nikolozka/teacher.solar/Documentation/annot.jpg

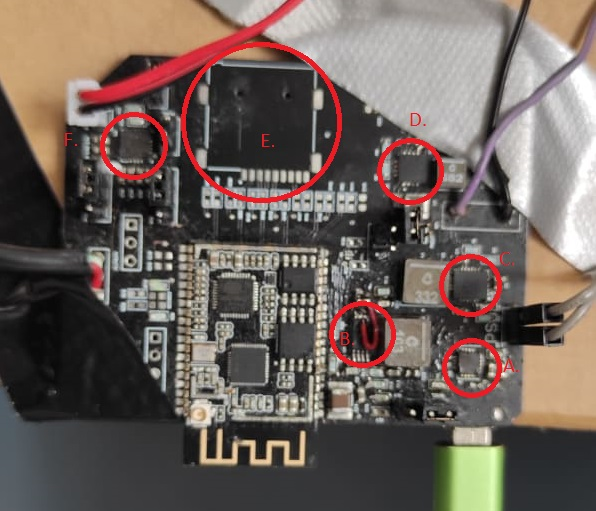
Documentation/annot.jpg
