nikolozka/teacher.solar/Documentation/242728832_872230910085273_4497362481227015161_n.jpg

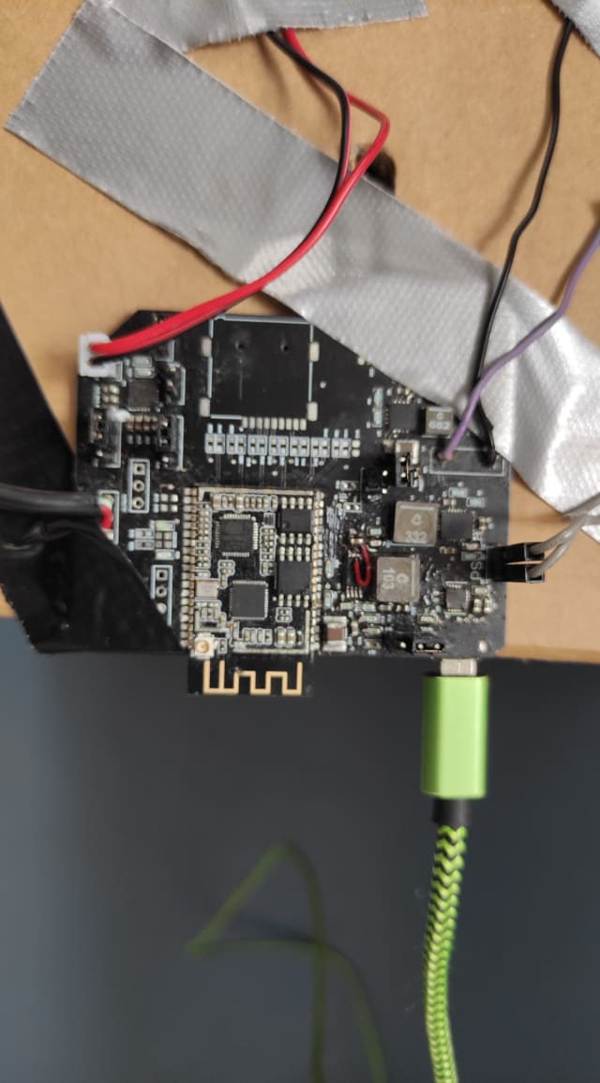
Documentation/242728832_872230910085273_4497362481227015161_n.jpg
