nikolozka/teacher.solar/Teacher.Solar/194192946_691922324912333_2375919402082609091_n.jpg

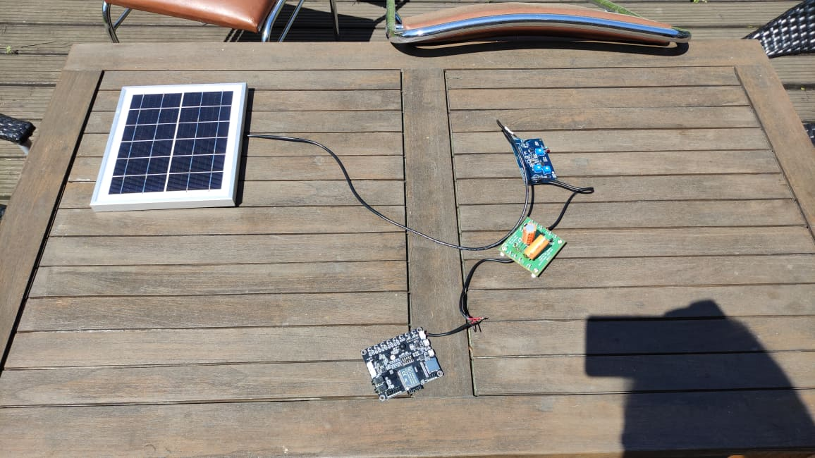
Teacher.Solar/194192946_691922324912333_2375919402082609091_n.jpg
