nikolozka/teacher.solar/(list of files, drawings)

Other design files:
PCB Projects/Solears_v1/Consumer.SchDoc
PCB Projects/Solears_v1/Harvester.SchDoc
PCB Projects/Solears_v1/Solears_v1.PcbDoc
PCB Projects/Solears_v1/Solears_v1.PrjPcb
PCB Projects/Solears_v3/Consumer.SchDoc
PCB Projects/Solears_v3/Harvester.SchDoc
PCB Projects/Solears_v3/PCB_Project/PCB_Project.PrjPcb
PCB Projects/Solears_v3/PCB_Project/Solears_V3.PrjPcb
PCB Projects/Solears_v3/Solears_v3.PcbDoc
