nikolozka/teacher.solar/Teacher.Solar/minisc.brd

## EAGLE design Teacher.Solar/minisc.brd (2023-11-09)

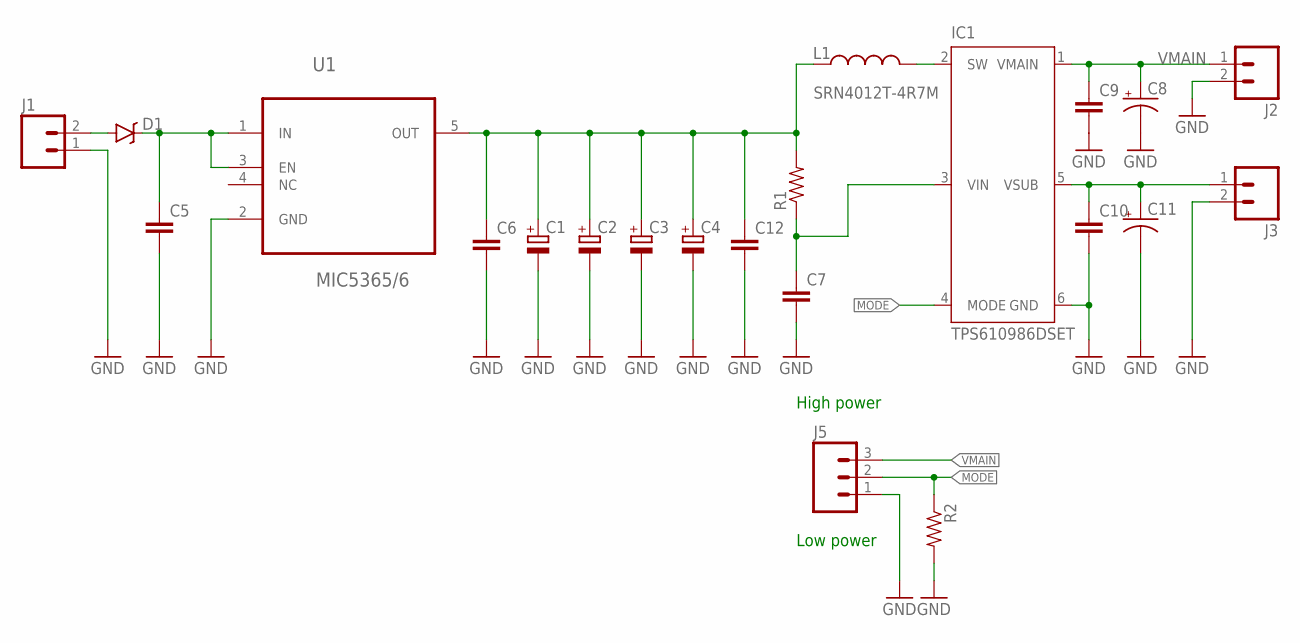
[picture p7: schematic minisc.sch]

Parts:
C1, C2, C3, C4: CPOL-EUE3.5-8; E3,5-8
C5, C6, C7, C9, C10, C12: CAP0805; 0805
C8, C11: CAP_POL3528-KIT; EIA3528-KIT
D1: DIODE-SCHOTTKY-BAT20J; SOD-323
IC1: TPS610986DSET; WSON-6
J1, J2, J3: M02PTH; 1X02
J5: M03PTH; 1X03
L1: SRN4012T-4R7M; CR54
R1, R2: RESISTOR0805-RES; 0805
U1: MIC5365/6; SC-70-5

Connections:
GND: C1.-, C2.-, C3.-, C4.-, C5.2, C6.2, C7.2, C8.C (-), C9.2, C10.2, C11.C (-), C12.2, IC1.6 (GND), J1.1, J2.2, J3.2, J5.1, R2.2, U1.2 (GND)
MODE: IC1.4 (MODE), J5.2, R2.1
unnamed: C5.1, D1.C, U1.1 (IN), U1.3 (EN)
unnamed: C1.+, C2.+, C3.+, C4.+, C6.1, C12.1, L1.P$1 (1), R1.2, U1.5 (OUT)
unnamed: IC1.2 (SW), L1.P$2 (2)
unnamed: C7.1, IC1.3 (VIN), R1.1
unnamed: C10.1, C11.A (+), IC1.5 (VSUB), J3.1
unnamed: D1.A, J1.2
VMAIN: C8.A (+), C9.1, IC1.1 (VMAIN), J2.1, J5.3

Notes on the sheet:
High power
Low power

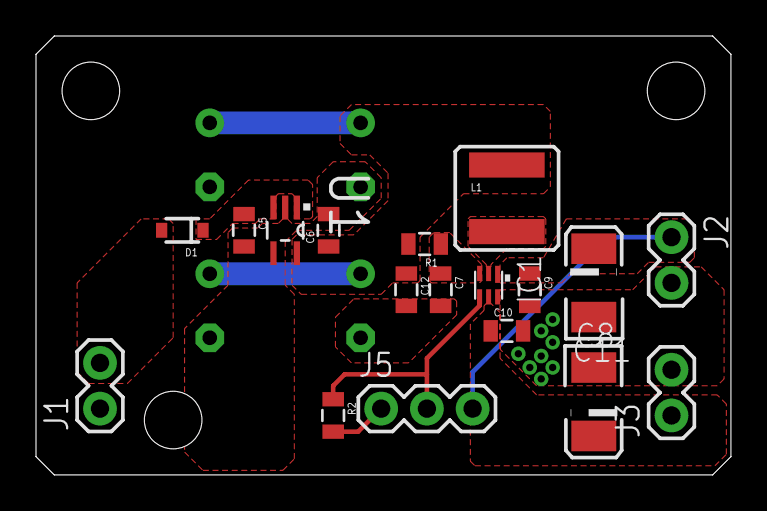
[picture p8: board minisc.brd from above]

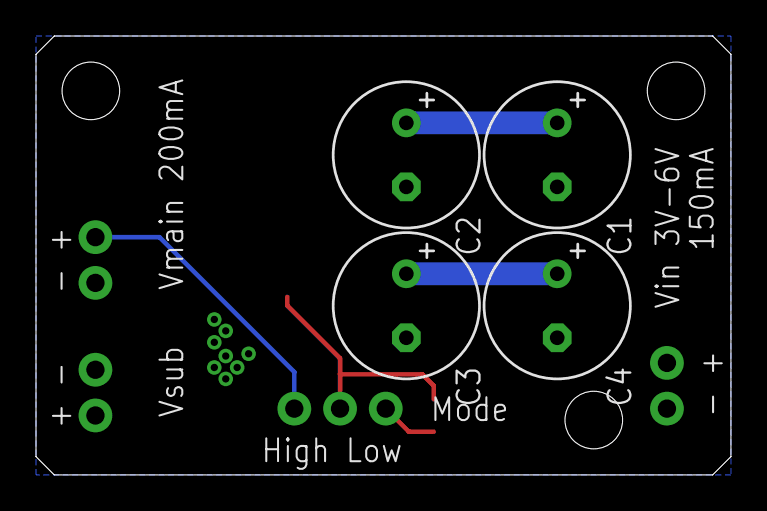
[picture p9: board minisc.brd from below]

Board: 2 copper layers, 38.6 x 24.4 mm, 22 parts (4 on the bottom side), 9 nets.
